Mobile-CHAP/design/Design Outline.jpeg

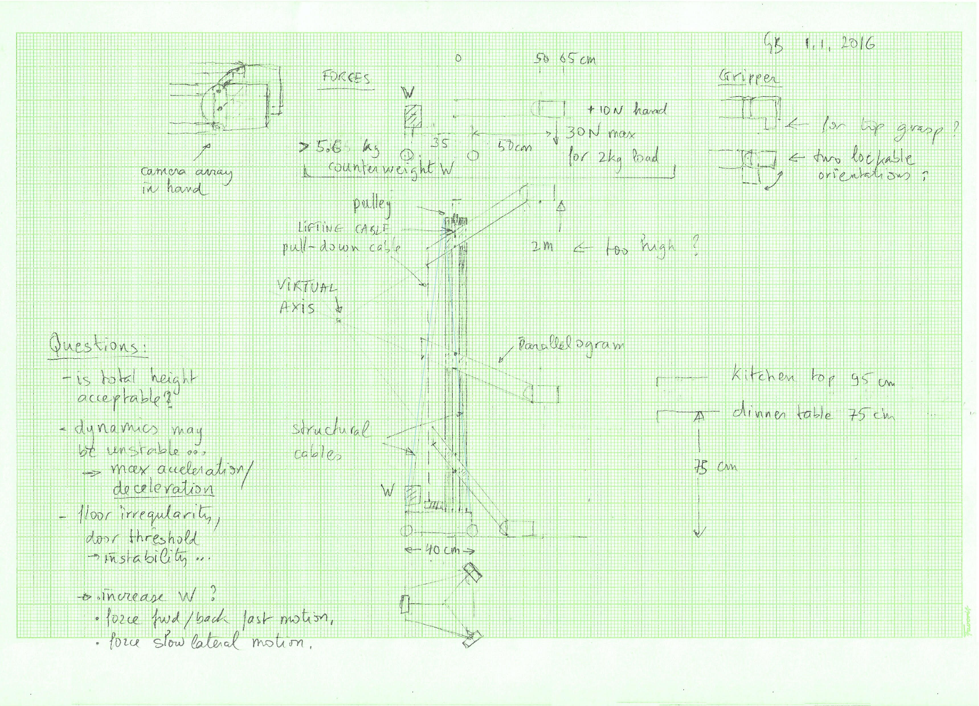
Design Outline.jpeg
