Mobile-CHAP/design/Dynamixel Repositories/MX28 Servo Line Diagram.png

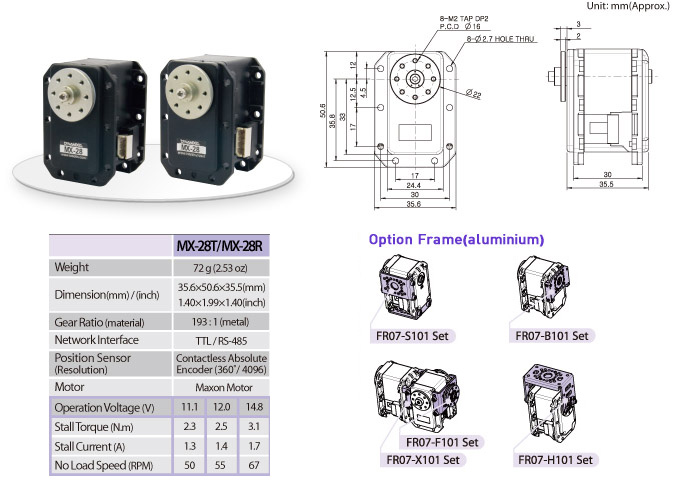
Dynamixel Repositories/MX28 Servo Line Diagram.png
