Mobile-CHAP/design/v1/3-ARM/2D/Readme.txt

For the plate at the back of the arm, you will need,
2 prints of plate1 of 3mm thickness e.g MDF
1 prints of splitplate 3mm thickness e.g. MDF 

For the plate at the midle of the arm (the one with the lift cable), you will need
1 print of 3 parts in "finasliderdwg.dxf"

For the plate holding the hand, look in the gripper folder.
