Mobile-CHAP/design/ToDo.md

#To-Print

- [ ] 1x Updated base
- [ ] 4x Sliders
- [ ] 1x Main Pully
- [ ] 1x Shaft

#To-Purchase
- [ ] 2x Rails (150cm)
