Mobile-CHAP/design/v1/NotesOn3DPrinting.txt

For 3D printing, files need to be save in .stl format

For laser cutting, file need to be .dxf

A format for transfering files between CAD software is .stp or .step (does not contain all parts information).
