Mobile-CHAP/design/v1/1-BASE/2D/Notes.txt

ring.dxf
is to be lasercut from 4-6 mm perspex.
Is part of the wheel axle.
