Mobile-CHAP/design/v1/4-GRIPPER/2D/notes.txt

The dxf files for the gripper are in the zip file in the CAD folder.
