Mobile-CHAP/design/thumbnail_CHAPConcept_2.jpg

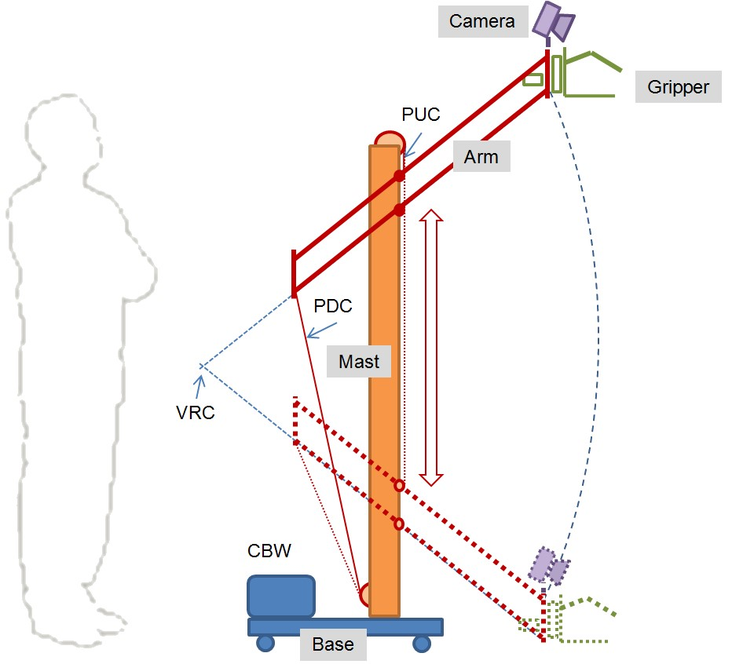
thumbnail_CHAPConcept_2.jpg
