Mobile-CHAP/design/v1/CostsOfParts.xlsx

Sheet: Sheet1
 |  |  | TOTAL | 1739.9
 | quantity |  | unit cost | cost | paid by: | supplier
Base
 | 3 | Dynamixel MX-28R | 188.3 | 564.9 | pu | Robosavy
 |  | (MX-28T also usable, possibly other servos)
 |  | (Note @12V max torque of 2.5 NM, max speed 55rpm, 4096 ticks per turn, multiturn function)
 | 3 | 3d printed servo and wheel holders | 25.6 | 25.6
 | 1 | 20mm Plywood board | 5 | 25.6 |  | used wood from home. Guessed price.
 | 1 | Board cutting to shape | £10 | 10 |  | (done at PU workshop)
 | 12 | M4 bolts 45-50mm + nuts | 0.1 | 1.2
 | 2 | nylon screws, M2.5x20mm, pack of 10 | 2.86 | 5.72 |  | https://www.rapidonline.com/toolcraft-slotted-countersunk-screws-din-963-polyamide-m2-5-x-20mm-pack-of-10-51-3192
 | 3 | Omniwheels (Transwheels FXA-115 2'' outer diam, 1/2'' bore) Catalog price $6.19, but by the time they arrive to the UK, it is probably closer to £10. | 10 | 30 | pu | http://store.kornylak.com/SearchResults.asp?searching=Y&sort=5&cat=3&show=10&page=1
 |  | (a modelwith a bigger diam would increase speed and max load)
 | 6 | Ball bearings 10 x 24mm (inner diam x outer diam) | 1.54 | 9.24 | pu | http://uk.rs-online.com/web/p/ball-bearings/6190086/
 | 3 | 4-pin 485 Dynamixel cables
 | 1 | CM700
 | 1 | USB2Dynamixel (insteadof CM700), directly driving the servos from the PI | 51.5 | 51.5 |  | https://robosavvy.com/store/robotis-usb2dynamixel-pc-interface-to-bioloid-bus.html
 |  |  |  |  |  | alternative to consider: https://robosavvy.com/store/robosavvy-usb-to-dynamixel-r-3mbps-rs485.html
 |  |  |  |  |  | (only £25)
 | 1 | pack of flat cable clips for attching cables under the base | 1 | 1 |  | The tool shed
 | 1 | Robotis - SMPS2Dynamixel: Power Supply adapter to the Dynamixel Bus, used for 4pin cables. | 6.6 | 6.6 |  | https://robosavvy.com/store/robotis-smps2dynamixel-power-supply-adapter-to-the-dynamixel-bus.html
 | 1 | 4pin servo cables (extended to 50cm length by cutting in the middle, the soldering extra cables in the middle) pack of 10 - 4 needed for the base. | 18.5 | 18.5 |  | https://robosavvy.com/store/robotis-dynamixel-4pin-cable-pack-200mm-20cm-10-units.html
 | 1 | battery MultiStar High Capacity 3S 5200mAh Multi-Rotor Lipo Pack (£32.89+£16.95 UK delivery) | 49.84 | 49.84 |  | e.g. a amazon for Hobbyking
 | 1 | Female battery connector: for xt60 (2 pairs in pack) | 2.7 | 2.7 |  | http://www.hobbyrc.co.uk/xt60-connectors-pair-1x-male-1x-female?gclid=CLn5rZChmdACFU46GwodPwwJsg
 | 1 | Balanced 3S battery charger 800mA (for instance this model) | 10 | 10 |  | https://robosavvy.com/store/turnigy-12v-2-3s-lipo-basic-balance-charger.html
 |  | (takes a 12VDC input)
 | 1 | 12VDC power supply 12W (e.g. this one) | 7.12 | 7.12 |  | http://uk.farnell.com/powerpax/sw4010e/ac-dc-converter-12w-12v-1a/dp/2424065?mckv=s_dc|pcrid|78108388509|kword||match||plid|&gross_price=true&CATCI=pla-41477300408&CAAGID=20220689949&CAGPSPN=pla&gclid=CMXpssCrmdACFQUW0wod7TsKuQ&DM_PersistentCookieCreated=true&CAWELAID=120173390000285000
Mast
 | 1 | 2 pieces Exterior plywood EN636 100 x 1620 x 5.5 mm | 11.27 | 11.27 |  | Totem timber
 |  | (Cost is for one piece of 2400x600 8.82 + cutting 2.25 - savings possible)
 | 1 | Planned redwood bar 70 x 20 (ish) | 2.39 | 2.39 |  | Totem Timber
 |  | (nominal E25x75 but smaller due to planning)
 | 2 | U-profile aluminium 10x20 | 8.28 | 16.56 |  | Totem Timber
 | 2 | packs of 1.5mm x 5m wire rope | 2.98 | 5.96 |  | Homebase
 | 1 | pack of 10 roofing bolts 50 x 5 | 2.4 | 2.4 |  | Totem
 |  | (for attaching the cables to the base)
 | 1 | pack of 4 furniture brackets | 1.08 | 1.08 |  | Totem
 |  | (for attaching the cables to the base)
 | 1 | pack of 4 wing nuts 5 mm | 1.62 | 1.62 |  | Totem
 |  | (for securing the roofing bolts by hand)
 | 1 | strip of 12 block connectors - 16A | 1.49 | 1.49 |  | Totem
 |  | (for attaching the mast cables)
 | 1 | set of: 100 x 8 mm bolt + 6 penny washers + 4 normal washers + nylock nut | 1.5 | 1.5 |  | Stainless Steel centre Plymouth
 |  | (For attachment of the cable at the top of the mast)
 |  | We ended up needing a 180mm thread - had to buy a steel rod (£1/m) and cut it to size) + 2 penny washers.
 | 1 | spacer tube 10+ x 70 | 0 | 0
 |  | (for bolt at top of mast, made form left-over of the arm bars)
 | 1 | Fork pulley 6x40mm | 5.36 | 5.36 |  | totem timber
 | 1 | Dyneema 2mm Various Colours English Braids Per 10 Metres (£4 for 10m + £2.5 postage) | 6.5 | 6.5 |  | ebay | in place of 6m Cord MOV2 Halyard Polyamid 2mm at 50p/m from Totem timber which is too elastic
 | 2 | Pulleys for weight reduction | 2 | 4 |  | H&W Knight&Son Surplus store Plymouth
 | 1 | 3D printed double pulley for arm raising | 9.84 | 9.84 | pu | PU
 | 2 | pinewood board 180x70x18mm, one end cut to shape. | 0 | 0 |  | From a shelf leg
 |  | for supporting the pulling force of the pulley at the bottom of the mast
 | 1 | motor mount + axel | 25.6 |  |  | 3d printed
 | 2 | nylon screws 2.5mm x | 0 | 0 |  | part of those bought for the wheel mounts.
 | 2 | Ball bearings 10 x 24mm (inner diam x outer diam) | 1.54 | 3.08 |  | same as for wheel mount
 | 1 | Dynamixel RX-64 (with HN05-N102 horn) | 276 | 276 | pu | https://robosavvy.com/store/robotis-dynamixel-rx-64-servo.html
 |  | For arm raising - has theoretically more than enough torque for a 3kg hand+load
Arm
 | 2 | Colorail Chrome 183cm x 19mm | 6.39 | 12.78 | gb | Totem
 |  | (actually "shower curtain rails", for the 4 bars of the robot arm)
 | 1 | RTM825 Light hardwood Dowel 18mm, 2.4m | 2.85 | 2.85 | gb | Totem
 |  | (for reinforcing the inside of the arm tubes)
 | 1 | laser cut arm holders 3mm, front, central and back plates mdf - 9 pieces (note that only 6 pieces are needed if a gripper if provided) | 9.99 | 9.99 | pu | PU
 | 4 | guides - 3D printed |  |  | gb | pu
 |  | nuts and bolt -
Gripper
 | 1 | aluminium metal plate (bendable type) 170 x 90x 3mm |  | 0 |  | Scrap from PU workshop
 | 1 | USB2Dynamixel (insteadof CM700), directly driving the servos from the PI, via the SMPS2. | 51.5 | 51.5 | pu | https://robosavvy.com/store/robotis-usb2dynamixel-pc-interface-to-bioloid-bus.html
 | 1 | Robotis - SMPS2Dynamixel: Power Supply adapter to the Dynamixel Bus, used for 3pin cables | 6.6 | 6.6 |  | https://robosavvy.com/store/robotis-smps2dynamixel-power-supply-adapter-to-the-dynamixel-bus.html
 | 2 | ax12A servos, incl horn | 40.5 | 81 |  | https://robosavvy.com/store/robotis-dynamixel-ax-12a.html
 | 1 | MX-28T, incl horn | 216.8 | 216.8 |  | https://robosavvy.com/store/robotis-dynamixel-mx-28t-servo-ttl.html
 | 1 | 3p dynamixel cables - pack of 10 | 15.3 | 15.3 |  | https://robosavvy.com/store/robotis-dynamixel-3pin-cable-pack-200mm-20cm-10-units.html
Cameras
 | 3 | ELP USB with Camera 2.1mm Lens 1080p Hd Free Driver USB Camera Module ,2.0 Megapixel(1080p) | 35.4 | 106.2 | sra | https://www.amazon.co.uk/ELP-Camera-Megapixel-Windows-Android/dp/B00KA7WSSU
 |  | from: SRA IS102100-109
Computing and Control
 | 1 | raspberry Pi 3 board | 31.49 | 31.49 |  | https://www.amazon.co.uk/Raspberry-Pi-Model-Quad-Motherboard/dp/B01CCOXV34?s=computers
 | 1 | DC DC Converter Module 12V To 5V 3A 15W Dual USB Output Power Car Adapter UK | 3.49 | 3.49 | gb | http://www.ebay.co.uk/itm/DC-DC-Converter-Module-12V-To-5V-3A-15W-Dual-USB-Output-Power-Car-Adapter-UK-/152019774301
 | 1 | 4-Ports-High-Speed-USB-Hub-Multi-Splitter-Expansion-USB-2-0-For-PS3-Xbox-Wii-PC | 1.99 | 1.99 | gb | http://www.ebay.co.uk/itm/251500688936
 |  | Note: Output 5V line to be cut!
 | 1 | Fellowes cable zip "calble eater", 2m | 12.77 | 12.77 | socme | Lyreco code 1.864.342 - http://www.lyreco.com/webshop/P03/product/view/000000000001864342?lc=ENEN
 | 1 | 2 x 13 Pin Header Straight 2.54mm Pitch 3A Gold Plated | 0.57 | 0.57 | sra | https://www.rapidonline.com/bkl-10120231-2-x-13-pin-header-straight-2-54mm-pitch-3a-gold-plated-50-8126
Notes: | Totem gives a 10% discount to Plymouth University staff.
 | 1 | PLA Nuclear Green 1.75mm 3D Printing Filament 1KG | 18 | 18 | pu | PLA Nuclear Green 1.75mm 3D Printing Filament 1KG
NOTE: |  | All the prices are from reputable suppliers - it may be possible to source components at a lower price elsewhere

Sheet: Sheet3
0.785925586
0.2941450859
0.4907010322 |  | a
0.9981494083 | AWDF
0.1873022877
0.6313012057
0.1401517529
0.1186023638
0.132592643
0.3430250965
0.01024993955
0.4842181075
0.547565757
0.7403329606 | CS
0.2851832882
0.2965457987
0.2850912291
0.2720276712
0.4780109905
0.3253174056 |  |  | \V
0.3512416536
0.6646114563
0.07458463849
0.8061299792
0.8841232229
0.3029573991
0.4882714875
0.03386809061
0.8882283332
0.4212762289
0.9316044722
0.4717544848 |  |  | CV
0.9199504101
