Mobile-CHAP/design/Dynamixel Repositories/rx64T.stp

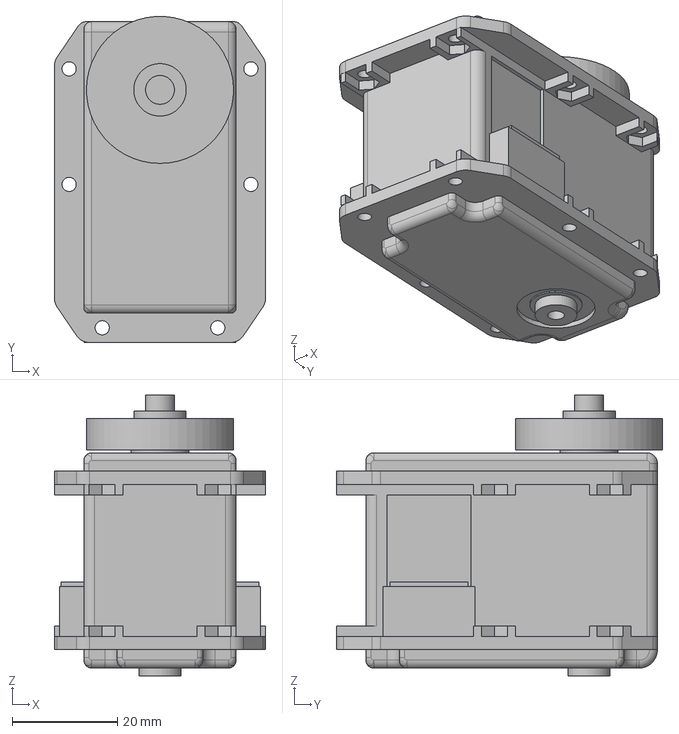
[picture p4: CAD file, 2016-09-27]
Dynamixel Repositories/rx64T.stp
40.2 x 62.1 x 53.5 mm
