Mobile-CHAP/design/pi-case/front.FCStd

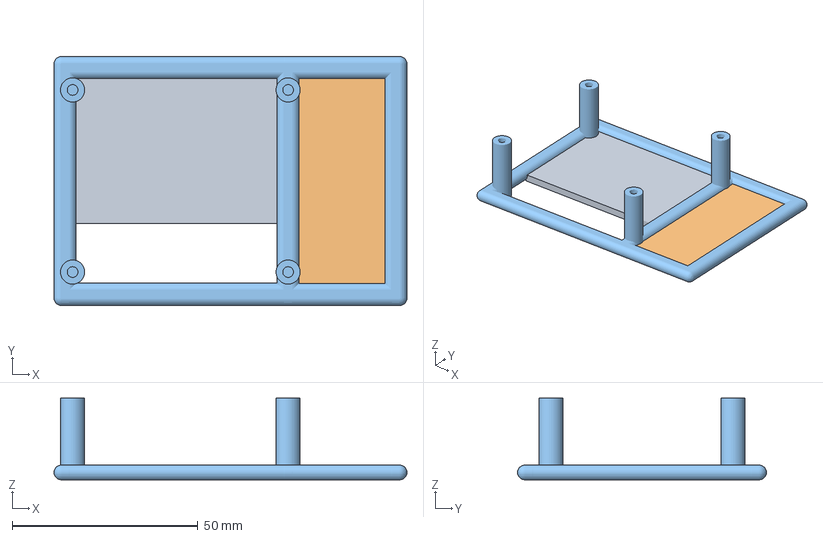
[picture p5: CAD file, 2016-09-27]
pi-case/front.FCStd
95.0 x 67.0 x 22.0 mm
pi_front
