Mobile-CHAP/design/v1/1-BASE/2D/ring.dxf

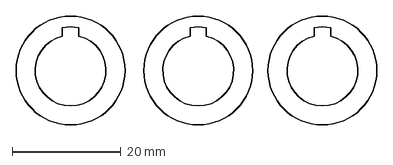
[picture p6: CAD file, 2017-01-16]
v1/1-BASE/2D/ring.dxf
66.3 x 20.0 mm
