Mobile-CHAP/design/v1/1-BASE/CAD/axle_cap.step

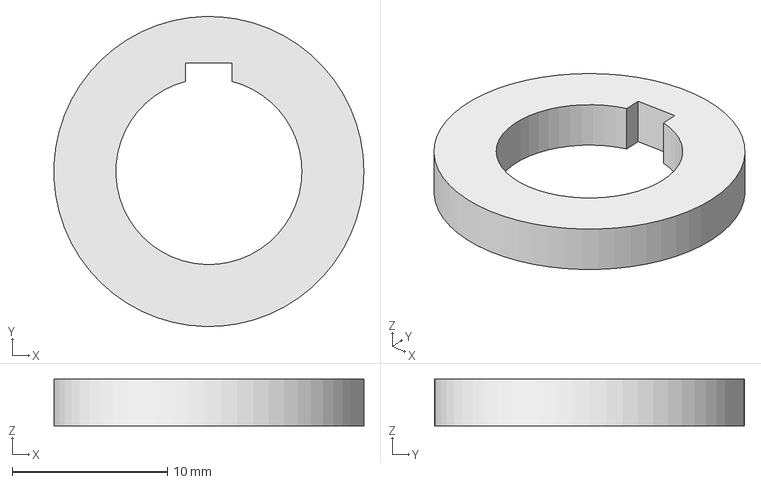
[picture p7: CAD file, 2017-01-16]
v1/1-BASE/CAD/axle_cap.step
20.0 x 20.0 x 3.00 mm
