Mobile-CHAP/design/v1/2-MAST/CAD/dual-pulley13.stp

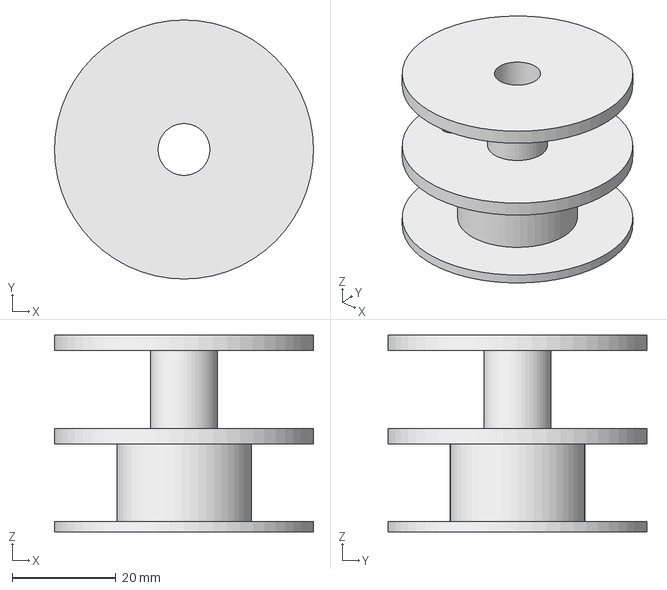
[picture p8: CAD file, 2017-01-16]
v1/2-MAST/CAD/dual-pulley13.stp
50.0 x 50.0 x 38.0 mm
