Mobile-CHAP/design/v1/3-ARM/2D/finalsliderdwg.dxf

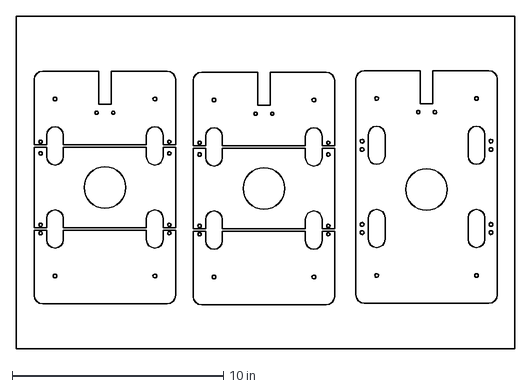
[picture p9: CAD file, 2017-01-16]
v1/3-ARM/2D/finalsliderdwg.dxf
23.6 x 15.7 in
