Mobile-CHAP/design/v1/3-ARM/CAD/rx64-mount.FCStd

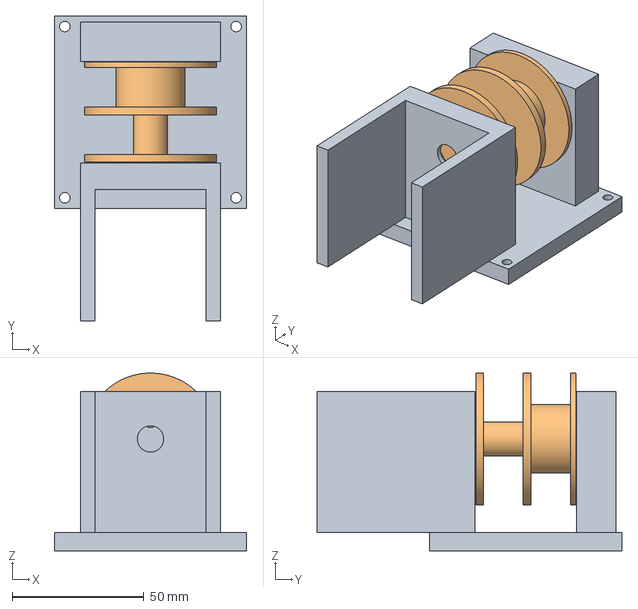
[picture p10: CAD file, 2016-09-27]
v1/3-ARM/CAD/rx64-mount.FCStd
73.0 x 115.8 x 67.5 mm
dual-pulley
