Mobile-CHAP/design/v1/4-GRIPPER/CAD/newaxelhand.stl

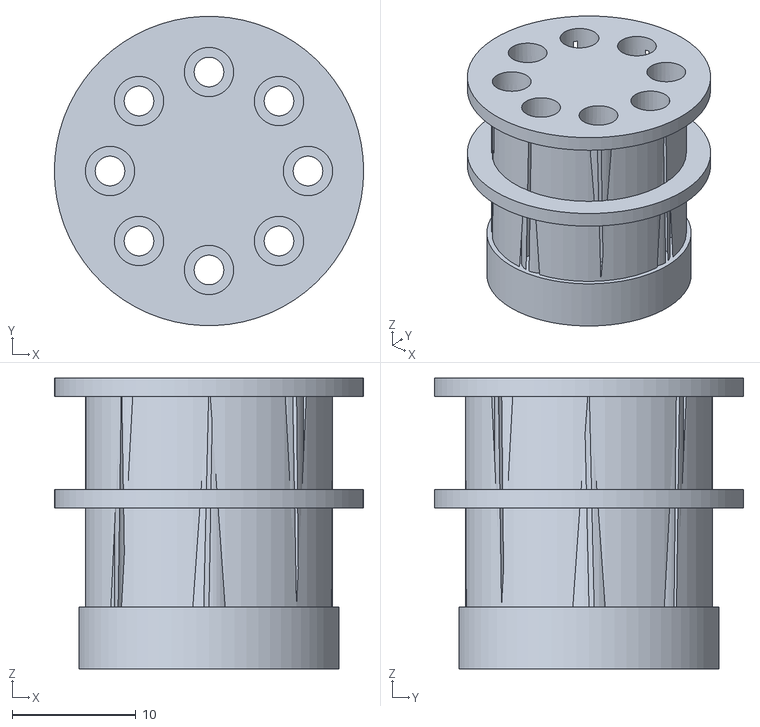
[picture p11: CAD file, 2017-01-16]
v1/4-GRIPPER/CAD/newaxelhand.stl
25.0 x 25.0 x 23.5
