Mobile-CHAP/design/v1/5. ELECTRICAL/2D/BatteryBox/2.SLDPRT

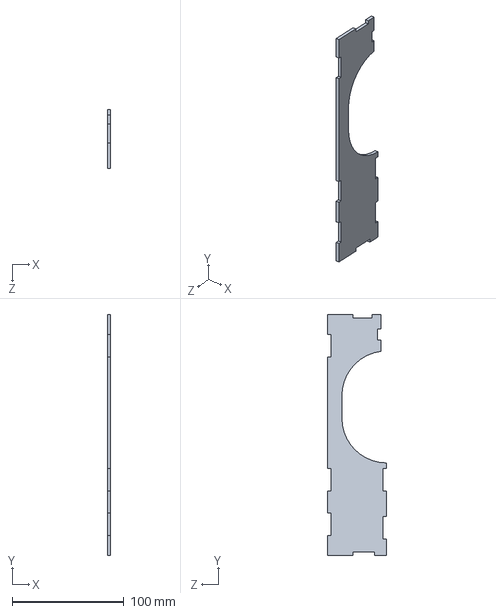
[picture p12: CAD file, 2017-01-16]
v1/5. ELECTRICAL/2D/BatteryBox/2.SLDPRT
3.00 x 216.0 x 53.0 mm
