Mobile-CHAP/design/Dynamixel Repositories/rx64H.stp

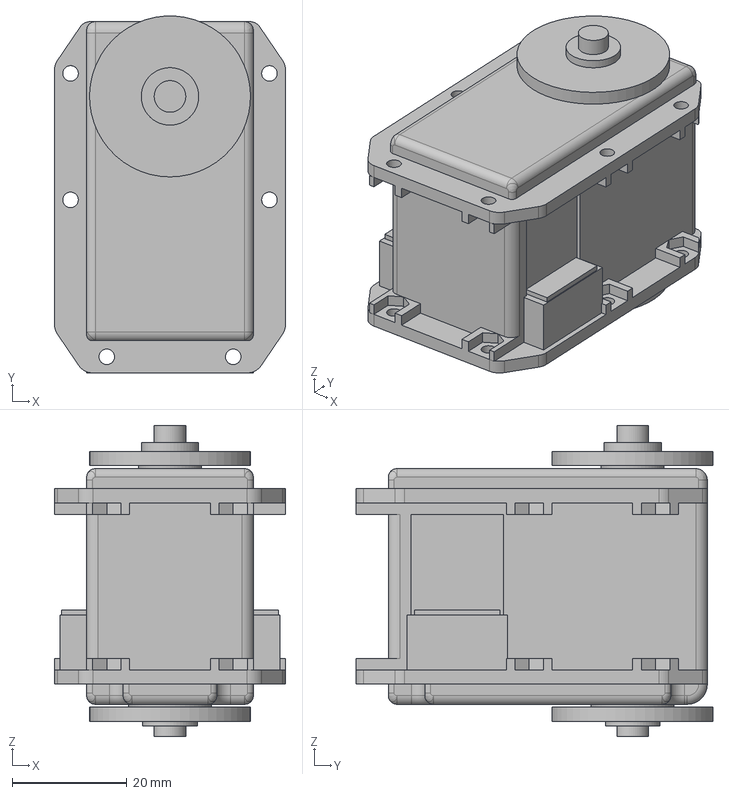
[picture p13: CAD file, 2016-09-27]
Dynamixel Repositories/rx64H.stp
40.2 x 62.1 x 54.1 mm
