Mobile-CHAP/design/pi-case/pi_back.stl

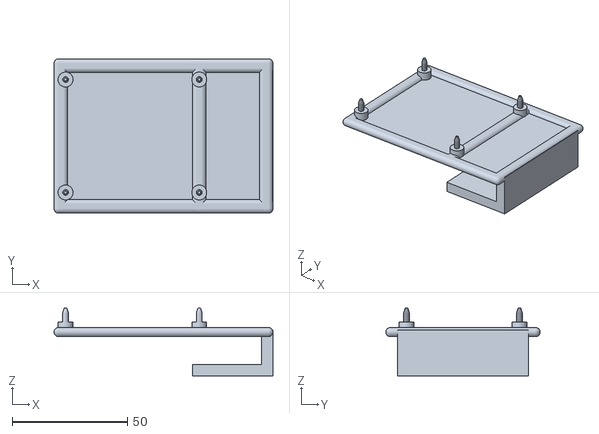
[picture p14: CAD file, 2016-09-27]
pi-case/pi_back.stl
95.0 x 67.0 x 29.4
