Mobile-CHAP/design/v1/1-BASE/2D/Baseplate.dxf

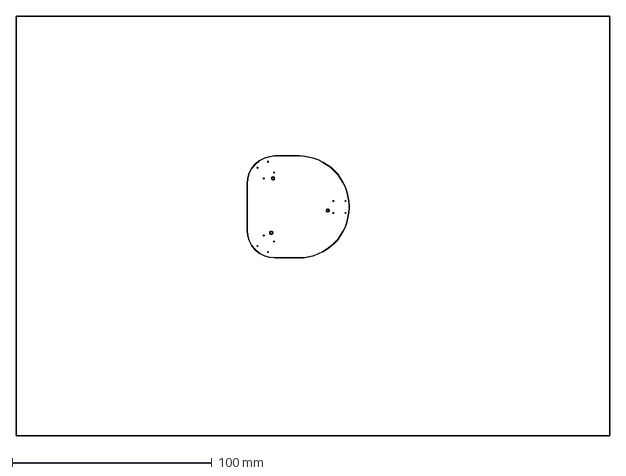
[picture p15: CAD file, 2016-09-27]
v1/1-BASE/2D/Baseplate.dxf
297.0 x 210.0 mm
