Mobile-CHAP/design/v1/1-BASE/CAD/WheelHousing.stp

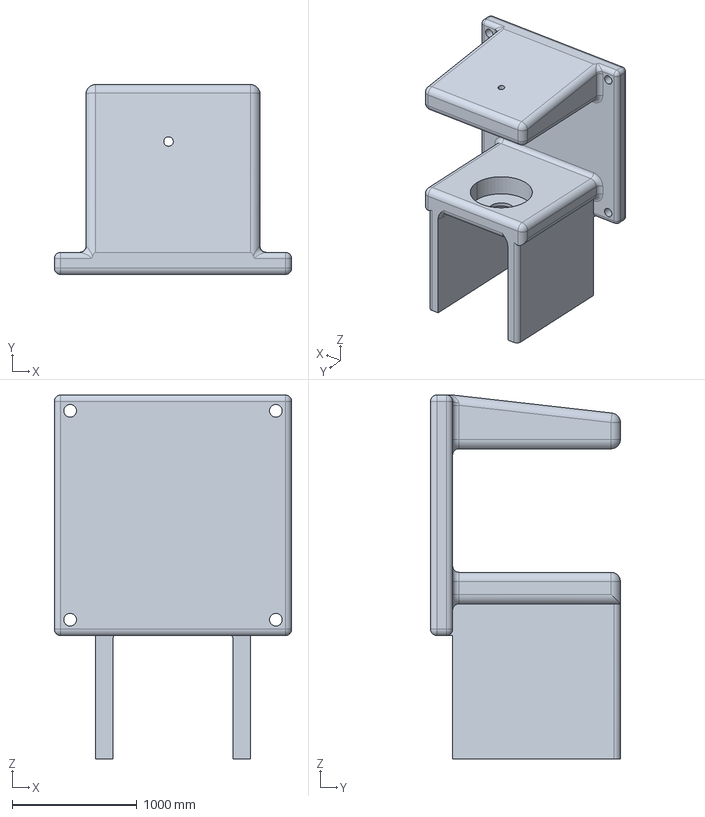
[picture p16: CAD file, 2016-09-27]
v1/1-BASE/CAD/WheelHousing.stp
1905.0 x 1524.0 x 2921.0 mm
