Mobile-CHAP/design/v1/4-GRIPPER/CAD/new-axle-hand.FCStd

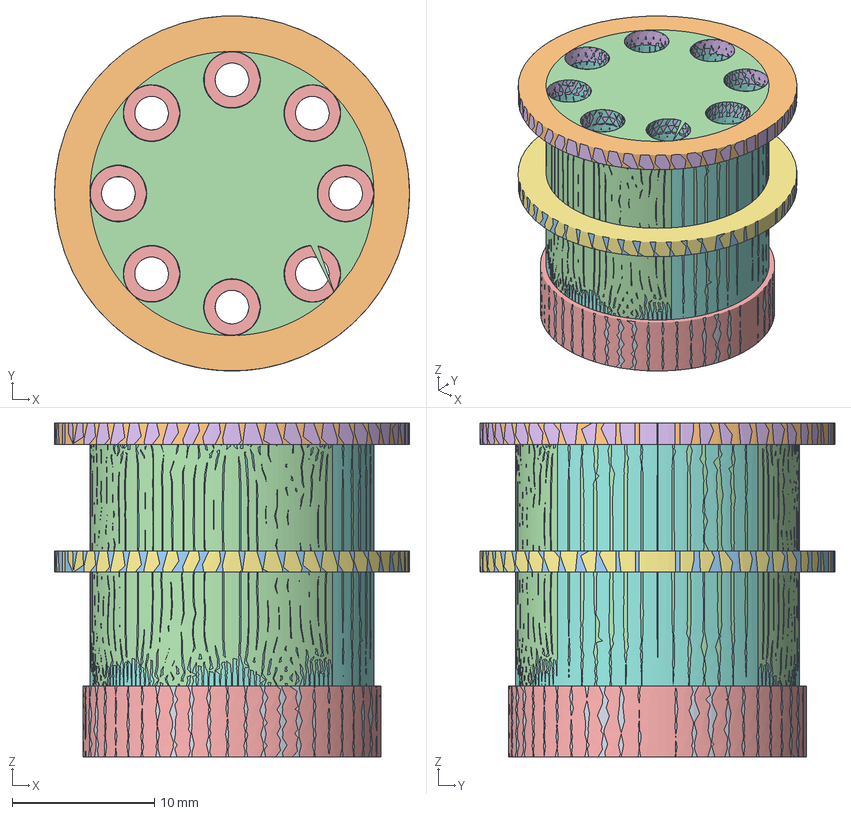
[picture p17: CAD file, 2017-01-16]
v1/4-GRIPPER/CAD/new-axle-hand.FCStd
25.0 x 25.0 x 23.5 mm
Extrude (Meshed)
Extrude003 (Meshed)
Extrude010 (Meshed)
Extrude017 (Meshed)
