Mobile-CHAP/design/v1/5. ELECTRICAL/2D/BatteryBox/3.SLDPRT

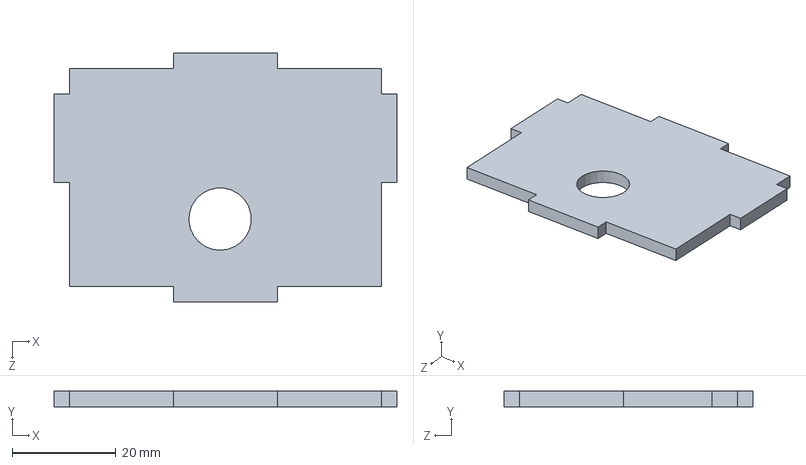
[picture p18: CAD file, 2017-01-16]
v1/5. ELECTRICAL/2D/BatteryBox/3.SLDPRT
66.0 x 3.00 x 48.0 mm
