Mobile-CHAP/design/Dynamixel Repositories/rx64N.stp

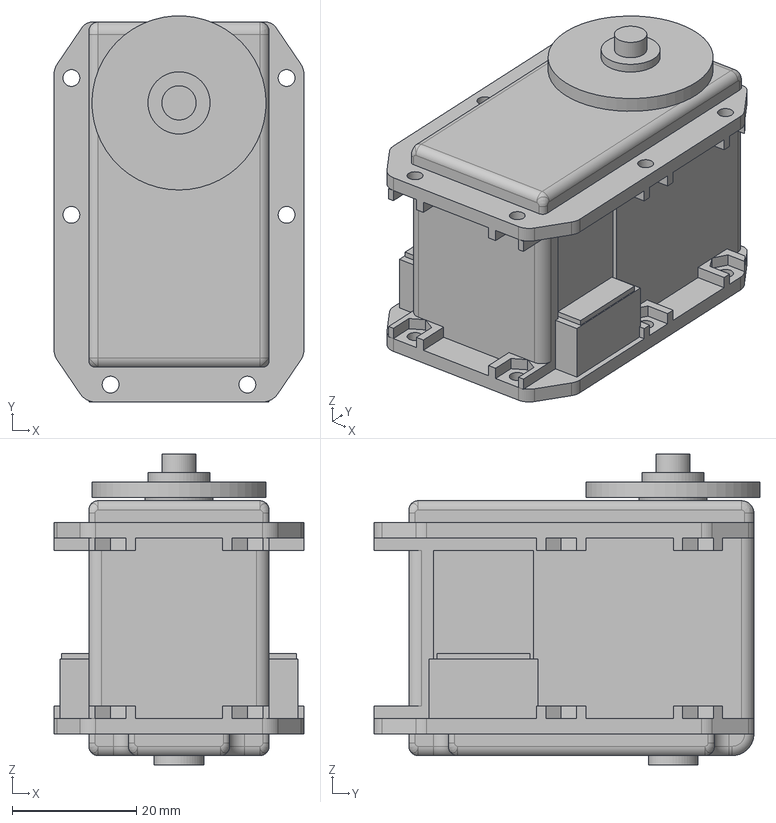
[picture p19: CAD file, 2016-09-27]
Dynamixel Repositories/rx64N.stp
40.2 x 62.1 x 50.0 mm
