Mobile-CHAP/design/v1/1-BASE/CAD/Base-New.stp

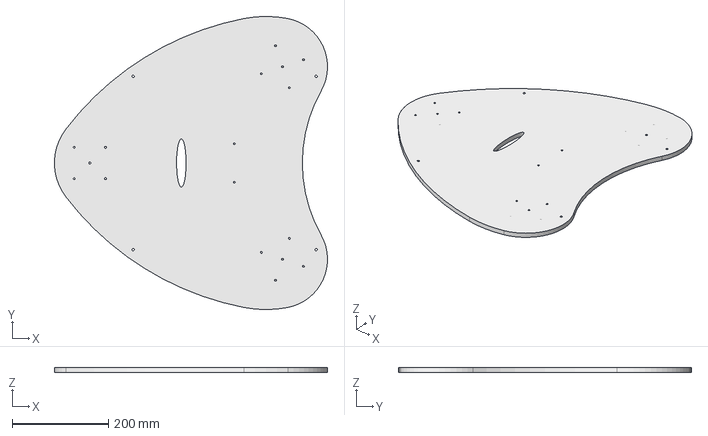
[picture p20: CAD file, 2016-09-27]
v1/1-BASE/CAD/Base-New.stp
566.9 x 608.8 x 10.0 mm
