Mobile-CHAP/design/v1/2-MAST/CAD/coupler-new.FCStd

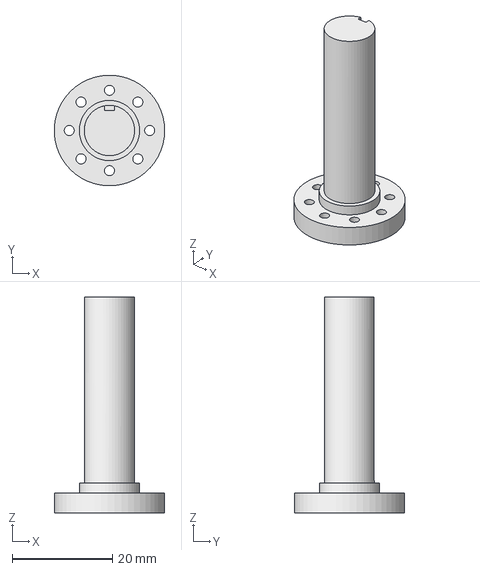
[picture p21: CAD file, 2016-09-27]
v1/2-MAST/CAD/coupler-new.FCStd
22.0 x 22.0 x 43.0 mm
