Mobile-CHAP/design/v1/3-ARM/2D/arm-slider.FCStd

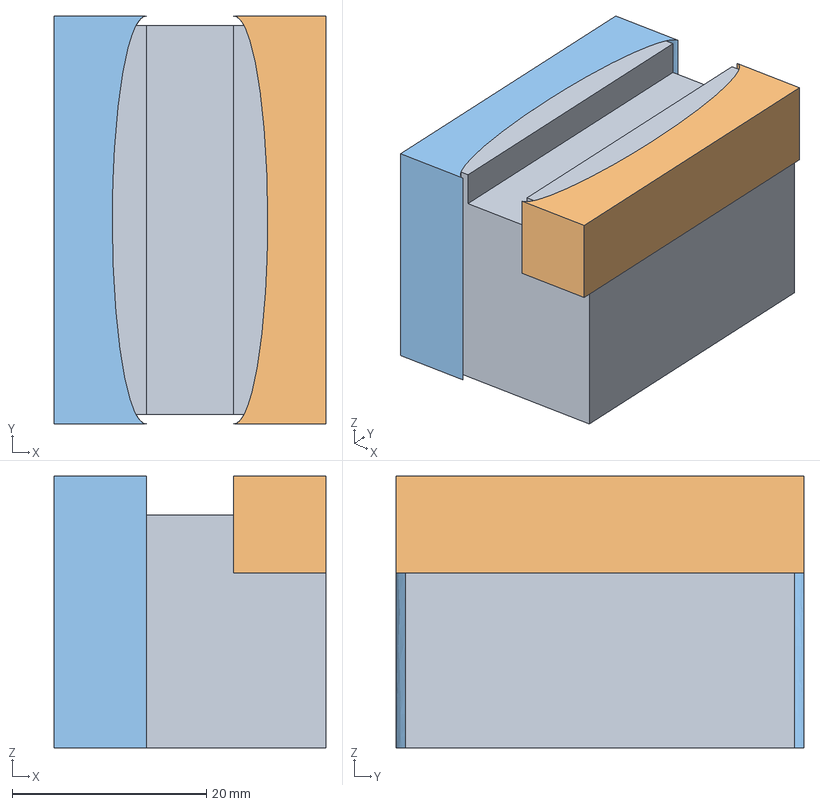
[picture p22: CAD file, 2016-09-27]
v1/3-ARM/2D/arm-slider.FCStd
28.0 x 42.0 x 28.0 mm
