Mobile-CHAP/design/v1/5. ELECTRICAL/2D/BatteryBox/6.SLDPRT

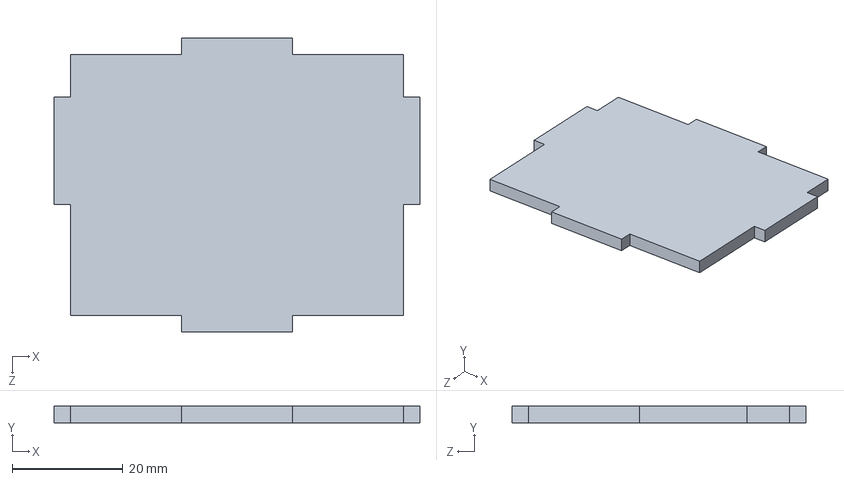
[picture p23: CAD file, 2017-01-16]
v1/5. ELECTRICAL/2D/BatteryBox/6.SLDPRT
66.0 x 3.00 x 53.0 mm
