Mobile-CHAP/design/v1/1-BASE/CAD/Coupler.stp

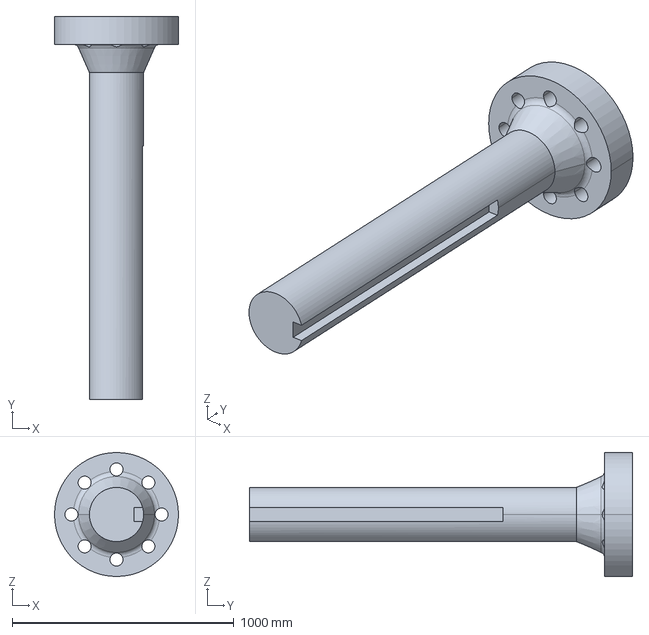
[picture p24: CAD file, 2016-09-27]
v1/1-BASE/CAD/Coupler.stp
558.8 x 1727.2 x 558.8 mm
