Mobile-CHAP/design/v1/3-ARM/2D/SplitPlate.stp

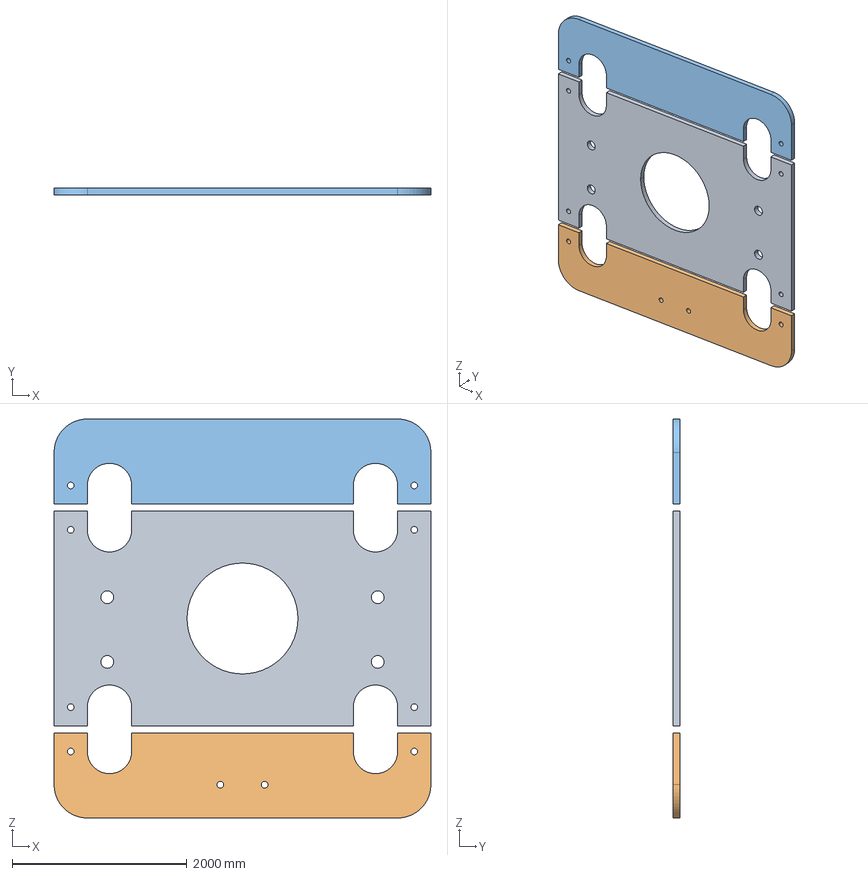
[picture p25: CAD file, 2016-09-27]
v1/3-ARM/2D/SplitPlate.stp
4318.0 x 76.2 x 4572.0 mm
