Mobile-CHAP/design/v1/5. ELECTRICAL/2D/BatteryBox/5.SLDPRT

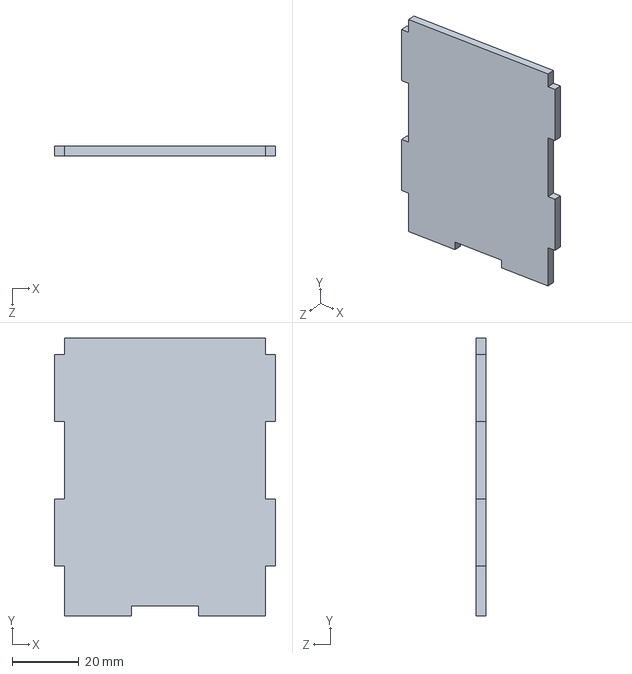
[picture p26: CAD file, 2017-01-16]
v1/5. ELECTRICAL/2D/BatteryBox/5.SLDPRT
66.0 x 83.0 x 3.00 mm
