Mobile-CHAP/design/v1/1-BASE/CAD/WheelMount.stp

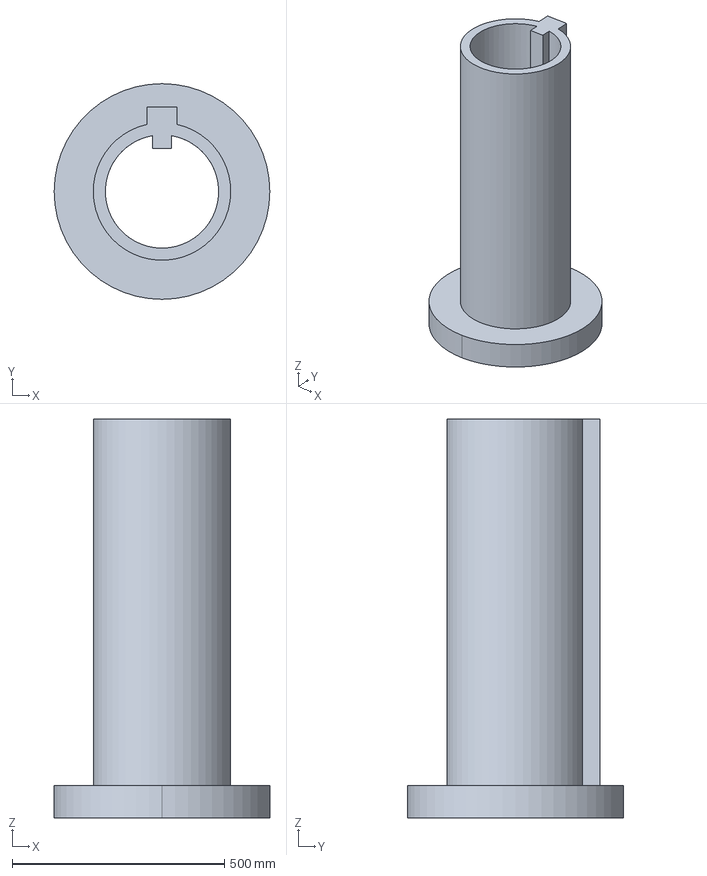
[picture p27: CAD file, 2016-09-27]
v1/1-BASE/CAD/WheelMount.stp
508.0 x 508.0 x 939.8 mm
