Mobile-CHAP/design/v1/3-ARM/2D/Plate1.stp

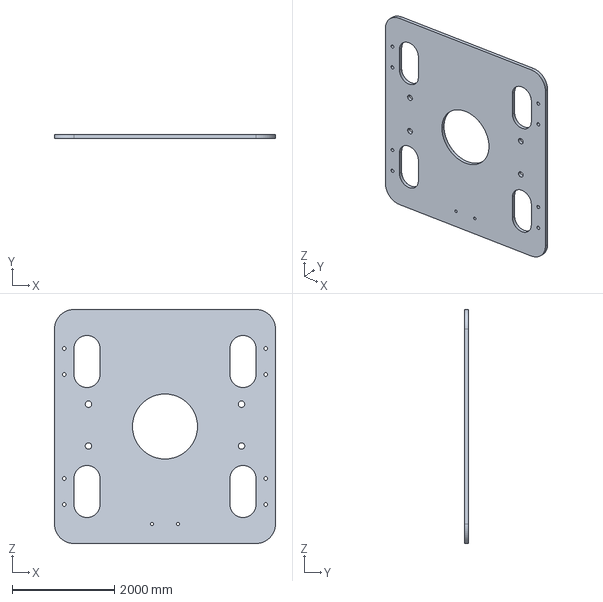
[picture p28: CAD file, 2016-09-27]
v1/3-ARM/2D/Plate1.stp
4318.0 x 76.2 x 4572.0 mm
