Mobile-CHAP/design/v1/5. ELECTRICAL/2D/BatteryBox/Guido Bugman Battery Pack.DXF

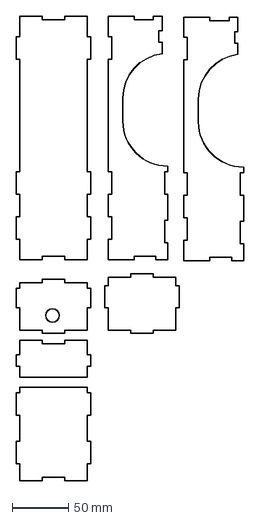
[picture p29: CAD file, 2017-01-16]
v1/5. ELECTRICAL/2D/BatteryBox/Guido Bugman Battery Pack.DXF
201.5 x 412.0 mm
