Mobile-CHAP/design/v1/1-BASE/CAD/new-axle-body.FCStd

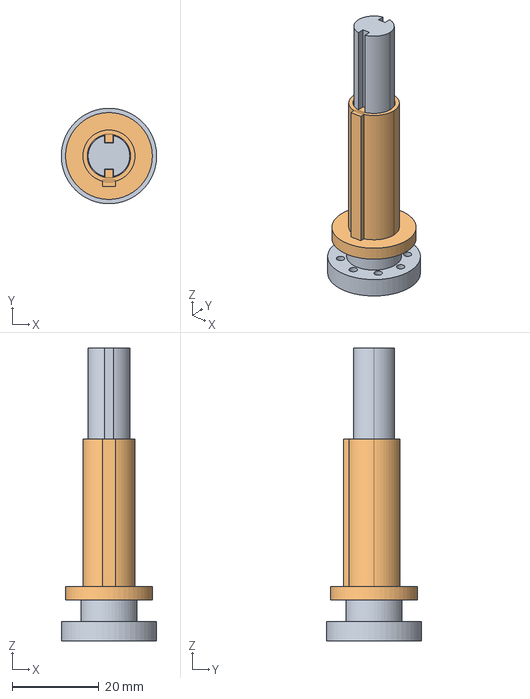
[picture p30: CAD file, 2016-09-27]
v1/1-BASE/CAD/new-axle-body.FCStd
22.0 x 22.0 x 67.5 mm
