Mobile-CHAP/design/v1/3-ARM/2D/arm-slider-x3.stl

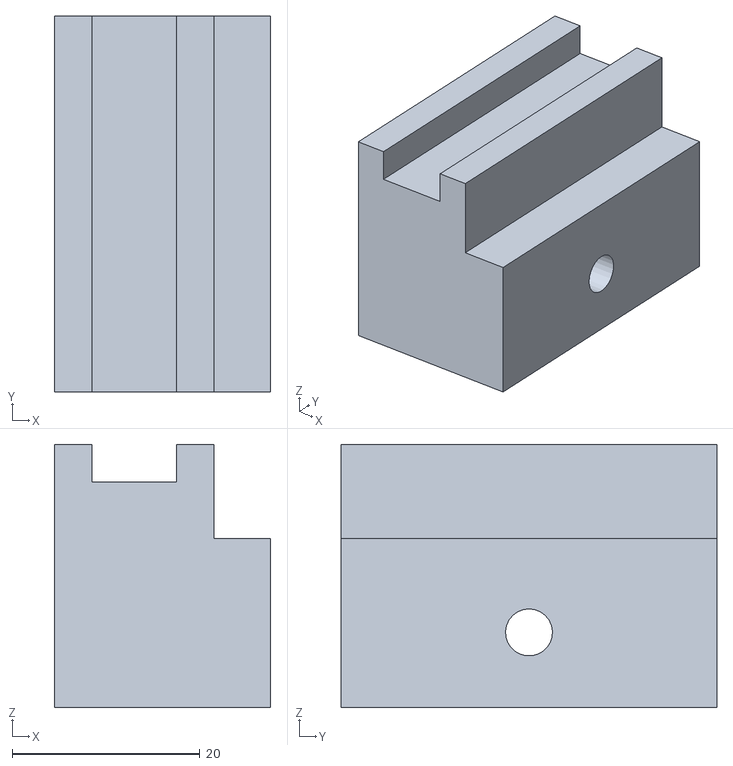
[picture p31: CAD file, 2016-09-27]
v1/3-ARM/2D/arm-slider-x3.stl
23.0 x 40.0 x 28.0
