Mobile-CHAP/design/v1/5. ELECTRICAL/2D/BatteryBox/1.SLDPRT

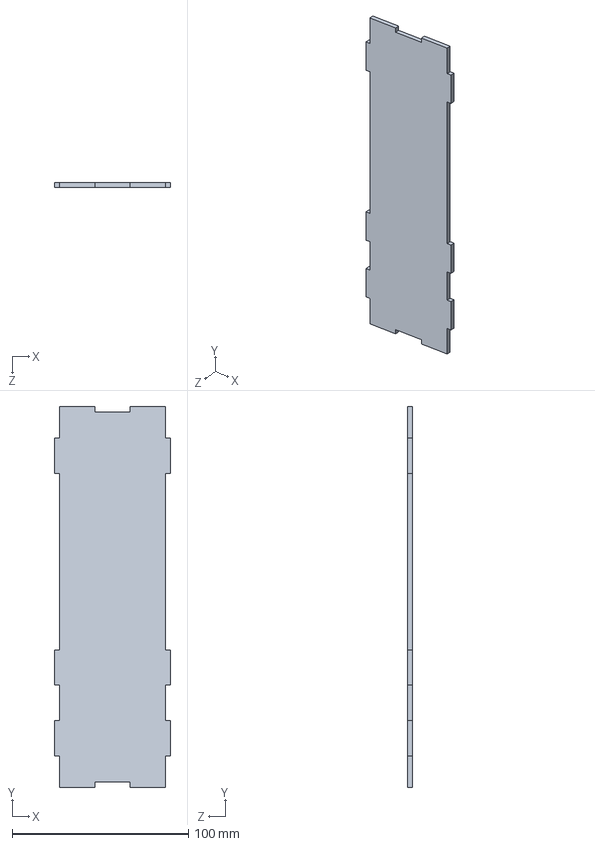
[picture p32: CAD file, 2017-01-16]
v1/5. ELECTRICAL/2D/BatteryBox/1.SLDPRT
66.0 x 216.0 x 3.00 mm
