Mobile-CHAP/design/v1/5. ELECTRICAL/2D/BatteryBox/4.SLDPRT

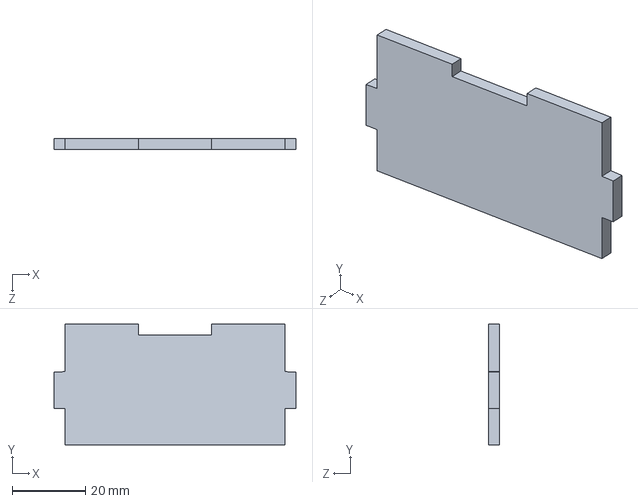
[picture p33: CAD file, 2017-01-16]
v1/5. ELECTRICAL/2D/BatteryBox/4.SLDPRT
66.0 x 33.0 x 3.00 mm
