Mobile-CHAP/design/(list of files, cad)

Other CAD files:
v1/3-ARM/2D/MiddleHolder.FCStd
v1/3-ARM/CAD/dual-pulley.FCStd
pi-case/back.FCStd
pi-case/pi_front.stl
v1/5. ELECTRICAL/2D/BatteryBox/7.SLDPRT
v1/1-BASE/CAD/axle-cap.FCStd
v1/1-BASE/CAD/axle-cap.stl
v1/1-BASE/CAD/coupler.stl
v1/1-BASE/CAD/new-axle-body.stl
v1/1-BASE/CAD/wheel-housing.stl
v1/1-BASE/CAD/wheelMount.stl
v1/2-MAST/CAD/dual-pulley13.FCStd
v1/3-ARM/2D/plate1.dxf
v1/3-ARM/2D/splitplate.dxf
v1/3-ARM/CAD/dual-pulley.stl
