Mobile-CHAP/design/Dynamixel Repositories/MX-28R.pdf

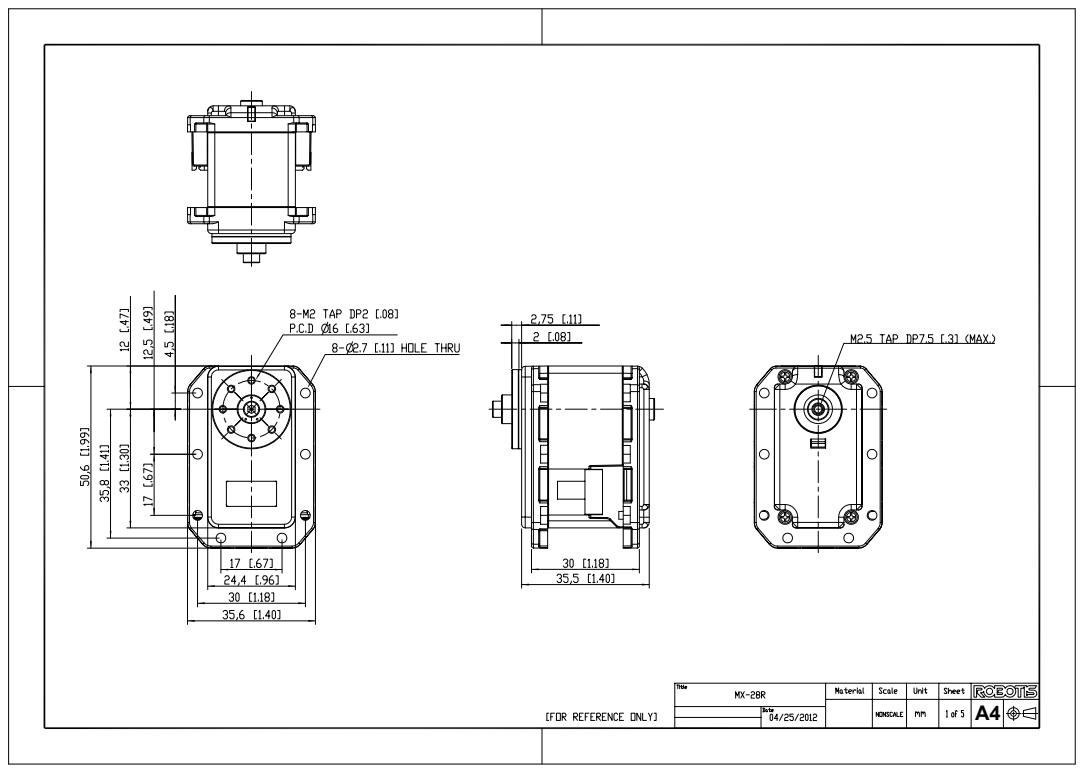
[picture p38: page 1]
