Mobile-CHAP/design/(commit log)

2016-09-27 First upload.
    [Base-New.stp, Baseplate.dxf, Coupler.stp, Plate1.stp, Pulley.stp, SplitPlate.stp, WheelHousing.stp, WheelMount.stp]
2017-01-16 Full instructions for CHAP v1
    [1.SLDPRT, 2.SLDPRT, 3.SLDPRT, 4.SLDPRT, 5.SLDPRT, 6.SLDPRT, 7.SLDPRT, Base-New.stp]
